patrickhirsh/Uniform-Keyboard/README.md

# Uniform65 Keyboard
A custom semi-ortholinear stabless mechanical keyboard
