patrickhirsh/Uniform-Keyboard/Ref/keyboard-layout-editor-schematic.txt

[{w:1.5},"Esc","1","2","3","4","5","6","7","8","9","0","-","=",{w:1.5},"Backspace"],
[{w:1.5},"Tab","Q","W","E","R","T","Y","U","I","O","P","[","]",{w:1.5},"|"],    
[{w:1.5},"Caps Lock","A","S","D","F","G","H","J","K","L",";","'",{w:1.5},"Enter","Home"],
[{w:1.5},"Shift","Z","X","C","V","B","N","M","<",">","?",{w:1.5},"Shift","Up","End"],
[{w:1.5},"Ctrl","Win","Alt",{x:0.5,w:1.5},"Space","Fn0",{w:1.5},"Space",{x:0.5},"Fn1","Fn2","Fn3",{x:0.5},"Left","Down","Right"]
