patrickhirsh/Uniform-Keyboard/Doc/Uniform_PCB_Wireframe.PNG

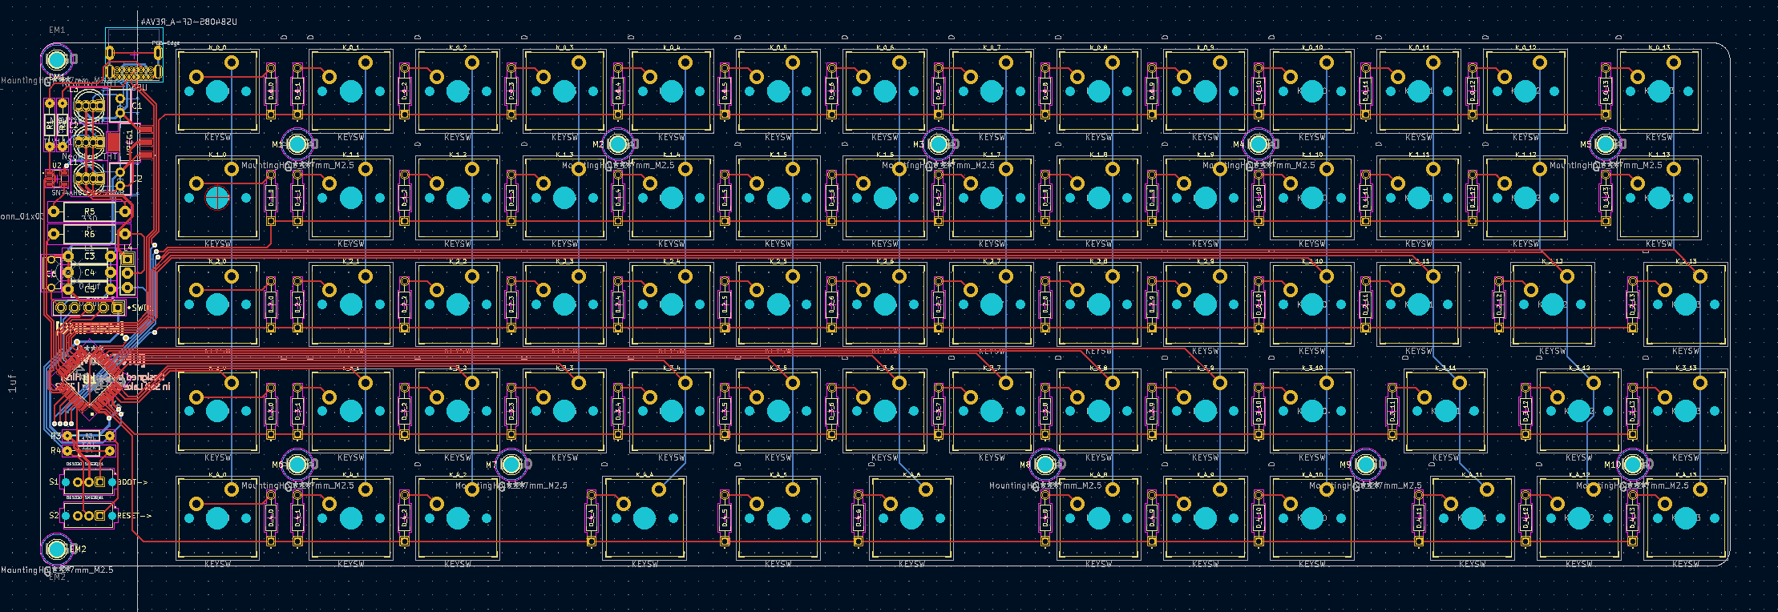
Doc/Uniform_PCB_Wireframe.PNG
