patrickhirsh/Uniform-Keyboard/Doc/Uniform_Tofu65_Example_2.jpeg

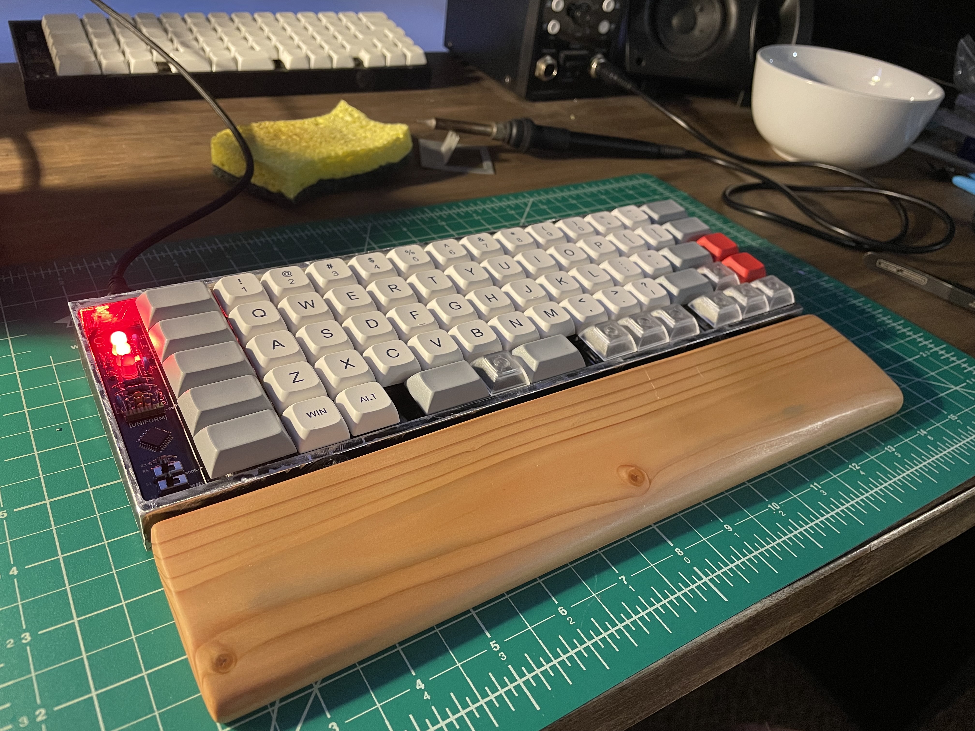
Doc/Uniform_Tofu65_Example_2.jpeg
