patrickhirsh/Uniform-Keyboard/Ref/keyboard-layout-matrix.PNG

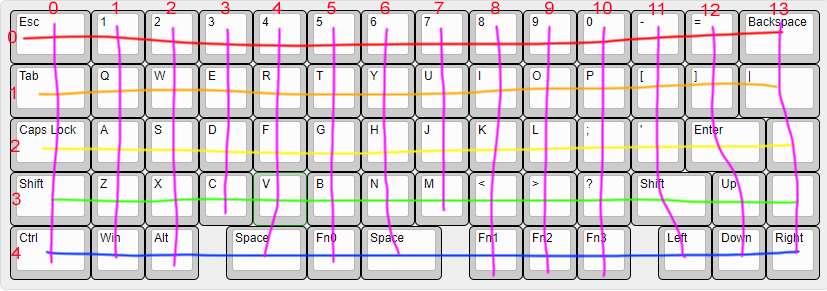
Ref/keyboard-layout-matrix.PNG
