patrickhirsh/Uniform-Keyboard/Ref/silkscreen graphics/graphic_designed-by-with-year.png

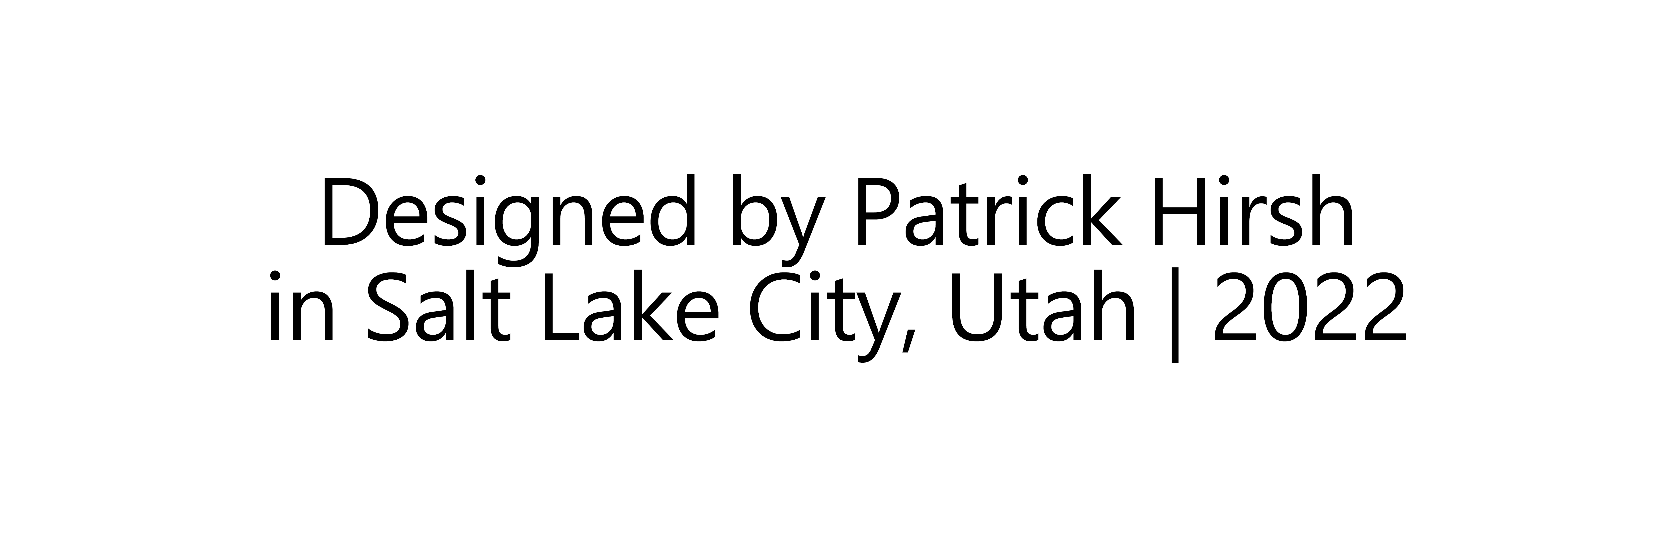
Ref/silkscreen graphics/graphic_designed-by-with-year.png
