patrickhirsh/Uniform-Keyboard/PCB/Uniform_Board/Uniform_Board.step

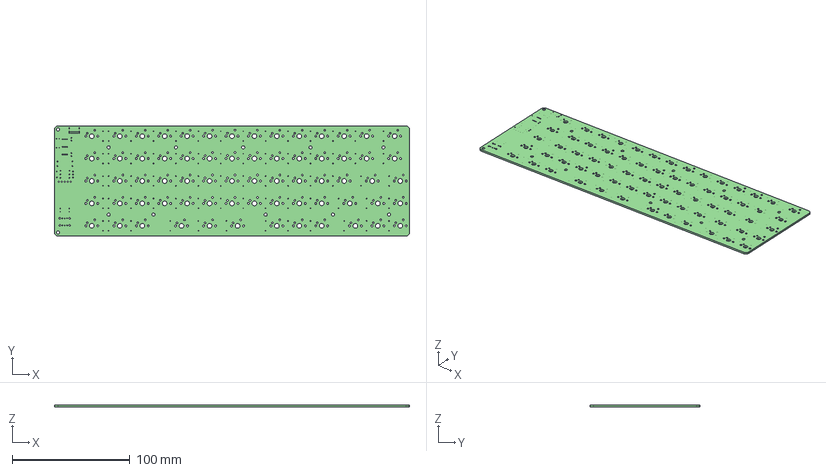
[picture p5: CAD file, 2022-08-30]
PCB/Uniform_Board/Uniform_Board.step
301.5 x 93.4 x 1.60 mm
