patrickhirsh/Uniform-Keyboard/Ref/uniform_layout.dxf

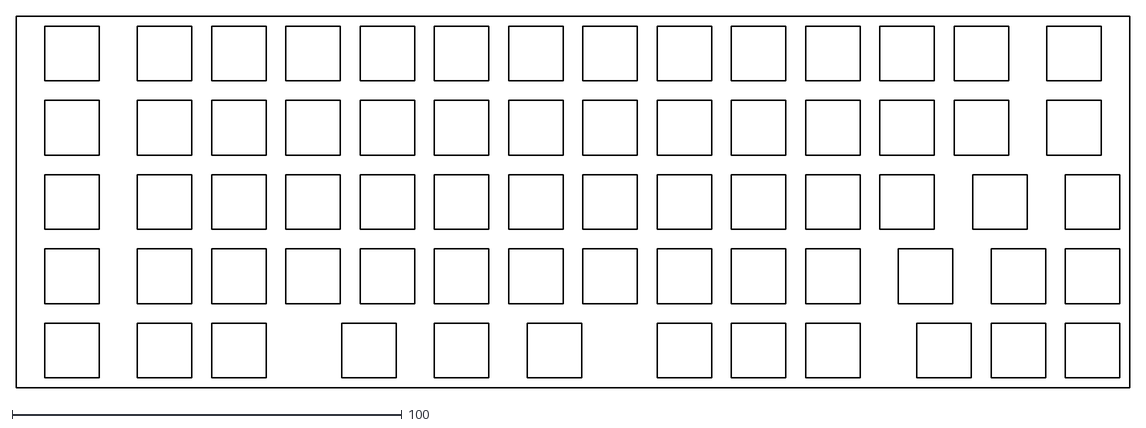
[picture p6: CAD file, 2022-02-06]
Ref/uniform_layout.dxf
285.7 x 95.2
