patrickhirsh/Uniform-Keyboard/PCB/lib-legacy/1-2199299-5/1-2199299-5.stp

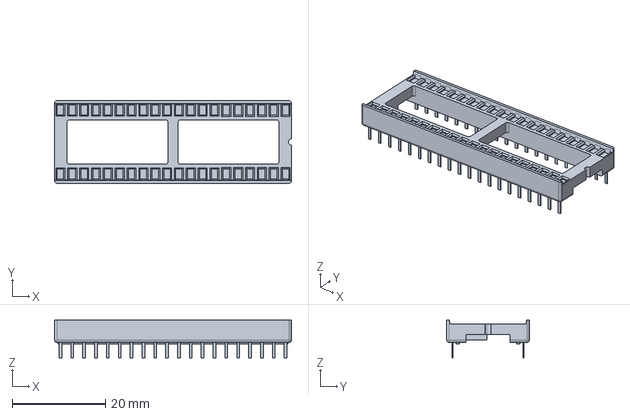
[picture p7: CAD file, 2022-05-01, an earlier design]
PCB/lib-legacy/1-2199299-5/1-2199299-5.stp
50.8 x 17.7 x 8.10 mm
