patrickhirsh/Uniform-Keyboard/PCB/lib-legacy/RCE5C2A220J0A2H03B-pcb-part-libraries/RCE5C2A220J0A2H03B.stp

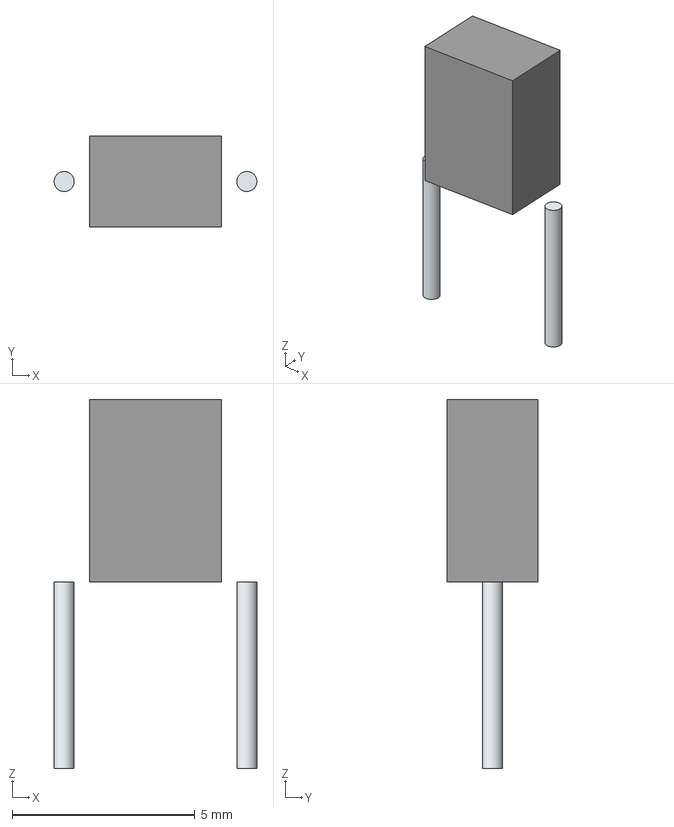
[picture p8: CAD file, 2022-05-01, an earlier design]
PCB/lib-legacy/RCE5C2A220J0A2H03B-pcb-part-libraries/RCE5C2A220J0A2H03B.stp
5.55 x 2.50 x 10.1 mm
Leads x 2
