patrickhirsh/Uniform-Keyboard/PCB/lib-legacy/RDER71H105K2M1H03A/RDER71H105K2M1H03A.step

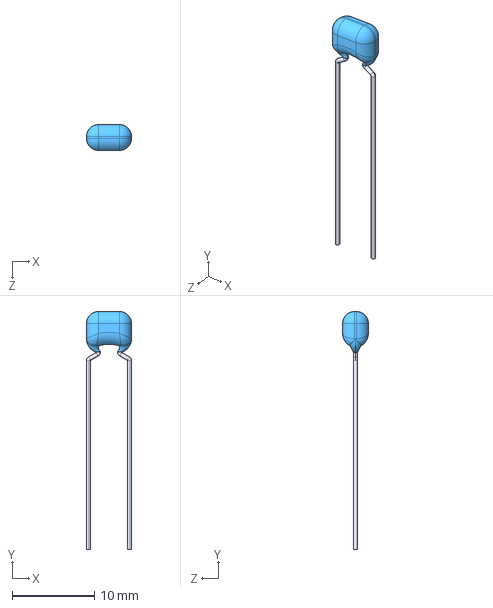
[picture p9: CAD file, 2022-02-09, an earlier design]
PCB/lib-legacy/RDER71H105K2M1H03A/RDER71H105K2M1H03A.step
5.50 x 29.0 x 3.15 mm
