patrickhirsh/Uniform-Keyboard/PCB/lib-legacy/SN74AHCT1G125DBVR/SN74AHCT1G125DBVR.step

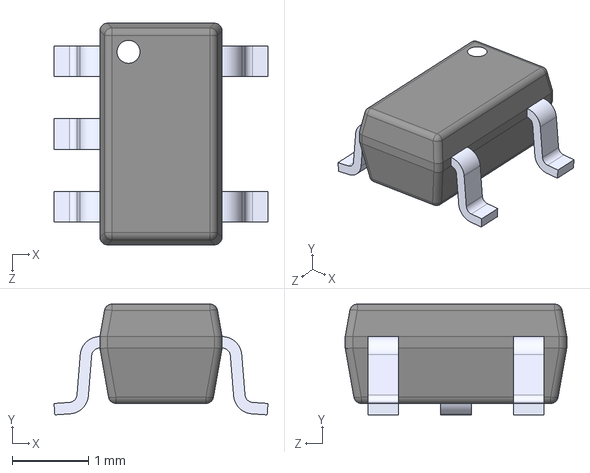
[picture p10: CAD file, 2022-05-30, an earlier design]
PCB/lib-legacy/SN74AHCT1G125DBVR/SN74AHCT1G125DBVR.step
2.80 x 1.45 x 2.90 mm
