patrickhirsh/Uniform-Keyboard/PCB/lib-legacy/STM32L072KZT6/STM32L072KZT6.stp

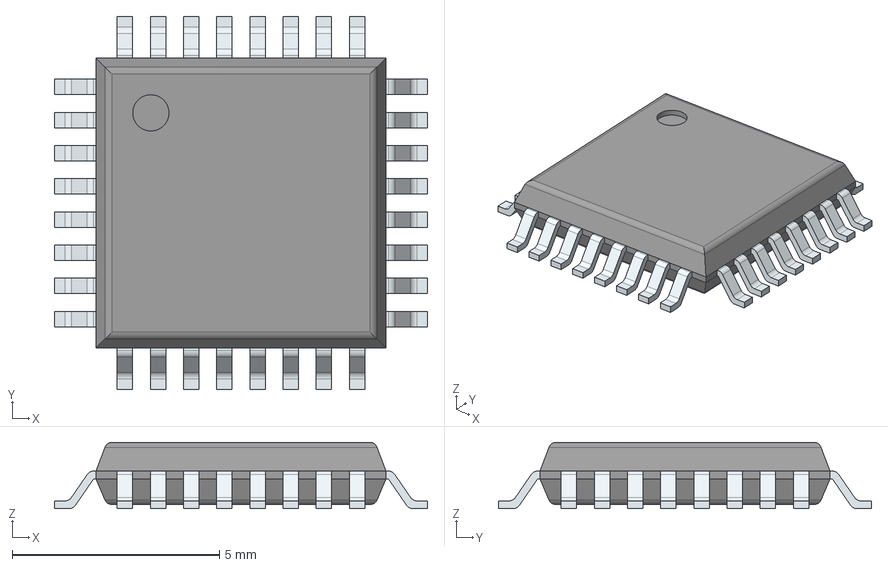
[picture p11: CAD file, 2022-02-08, an earlier design]
PCB/lib-legacy/STM32L072KZT6/STM32L072KZT6.stp
9.00 x 9.00 x 1.60 mm
PinsArrayLR
PinsArrayTB
