patrickhirsh/Uniform-Keyboard/PCB/lib-legacy/TLV1117-33IDCY/TLV1117-33IDCY.step

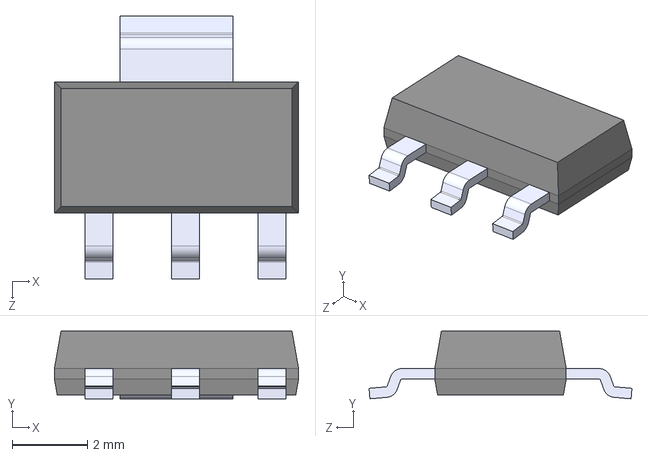
[picture p12: CAD file, 2022-02-06, an earlier design]
PCB/lib-legacy/TLV1117-33IDCY/TLV1117-33IDCY.step
6.50 x 1.80 x 7.00 mm
