patrickhirsh/Uniform-Keyboard/PCB/lib-legacy/826629-5/826629-5.step

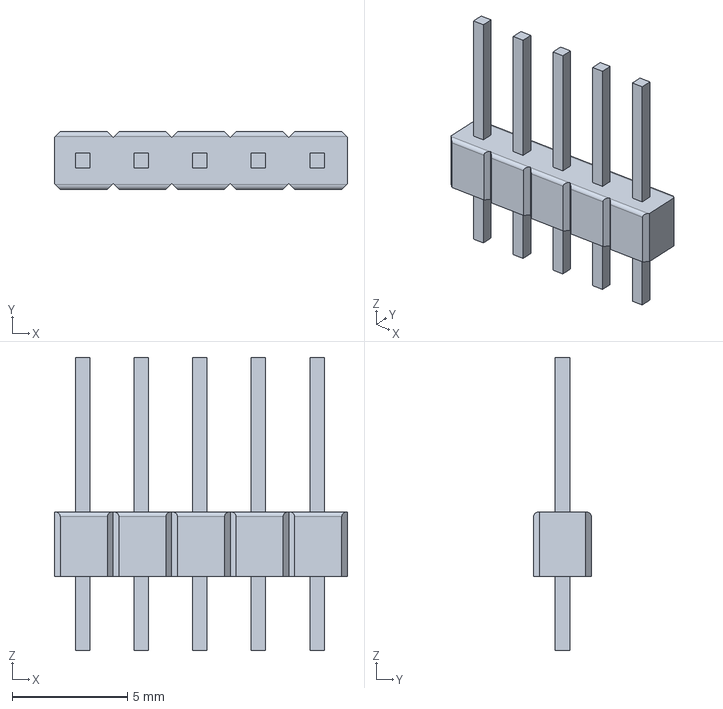
[picture p13: CAD file, 2022-02-08, an earlier design]
PCB/lib-legacy/826629-5/826629-5.step
12.7 x 2.50 x 12.7 mm
