patrickhirsh/Uniform-Keyboard/PCB/lib-legacy/OS102011MS2QN1/OS102011MS2QN1.step

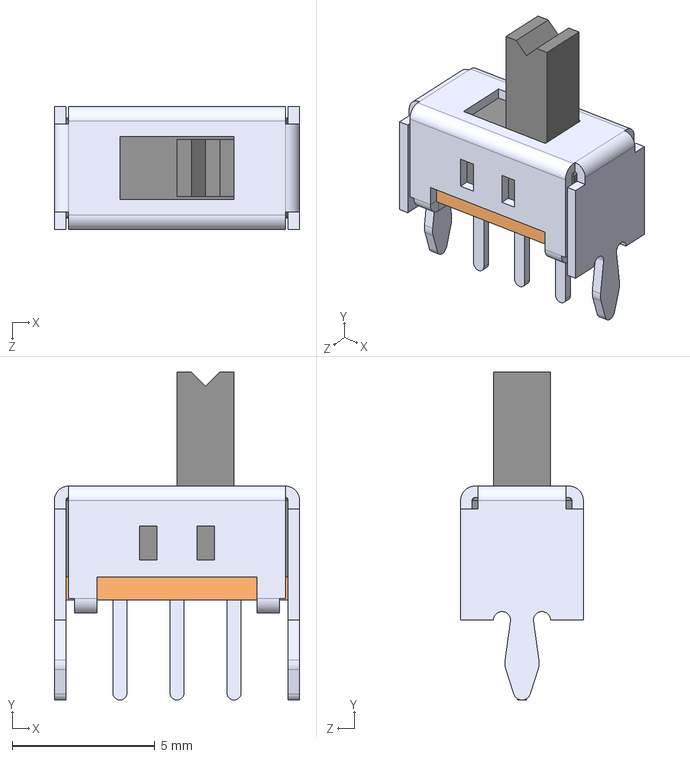
[picture p14: CAD file, 2022-02-07, an earlier design]
PCB/lib-legacy/OS102011MS2QN1/OS102011MS2QN1.step
8.60 x 11.5 x 4.30 mm
