patrickhirsh/Uniform-Keyboard/(list of files, cad)

Other CAD files:
PCB/lib-legacy/RCE5C2A220J0A2H03B-pcb-part-libraries/RCE5C2A220J0A2H03B.stl
PCB/lib-legacy/STM32L072KZT6/STM32L072KZT6.stl
