patrickhirsh/Uniform-Keyboard/PCB/Uniform_Module/Uniform_Module.kicad_pcb

## KiCad design PCB/Uniform_Module/Uniform_Module.kicad_pcb (2024-03-03)

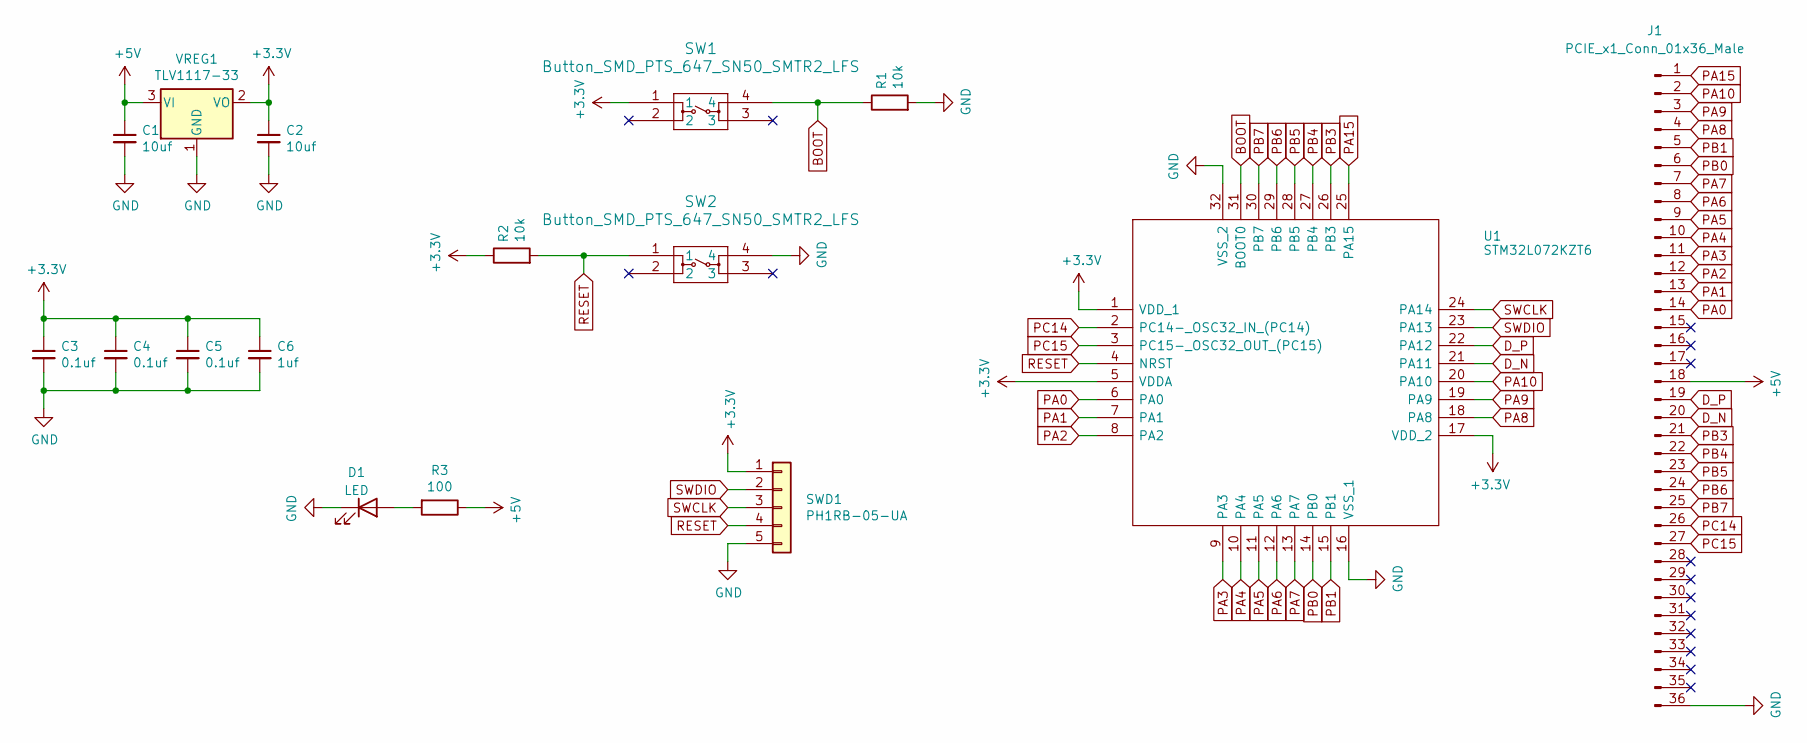
[picture p35: schematic Uniform_Module.kicad_sch, Uniform Keyboard]

Parts:
C1, C2: 10uf; C_0603_1608Metric_Pad1.08x0.95mm_HandSolder
C3, C4, C5: 0.1uf; C_0603_1608Metric_Pad1.08x0.95mm_HandSolder
C6: 1uf; C_0603_1608Metric_Pad1.08x0.95mm_HandSolder
D1: LED; LED_0603_1608Metric_Pad1.05x0.95mm_HandSolder
J1: PCIE_x1_Conn_01x36_Male; SAMTEC_PCIE_x1_CARD_EDGE_02_X_D_TH
R1, R2: 10k; R_0603_1608Metric_Pad0.98x0.95mm_HandSolder
R3: 100; R_0603_1608Metric_Pad0.98x0.95mm_HandSolder
SW1, SW2: Button_SMD_PTS_647_SN50_SMTR2_LFS; Button SMD PTS 647 SN50 SMTR2 LFS
SWD1: PH1RB-05-UA; PinHeader_1x05_P2.54mm_Vertical
U1: STM32L072KZT6; QFP80P900X900X160-32N; Mouser Part Number 511-STM32L072KZT6
VREG1: TLV1117-33; SOT230P700X180-4N

Connections:
+3V3: C2.1, C3.1, C4.1, C5.1, C6.1, R2.1, SW1.1, SWD1.1, U1.1 (VDD_1), U1.5 (VDDA), U1.17 (VDD_2), VREG1.2 (VO)
+5V: C1.1, J1.18, R3.1, VREG1.3 (VI)
BOOT: R1.1, SW1.4, U1.31 (BOOT0)
D_N: J1.20, U1.21 (PA11)
D_P: J1.19, U1.22 (PA12)
GND: C1.2, C2.2, C3.2, C4.2, C5.2, C6.2, D1.1 (K), J1.36, R1.2, SW2.4, SWD1.5, U1.16 (VSS_1), U1.32 (VSS_2), VREG1.1 (GND)
unnamed: D1.2 (A), R3.2
PA0: J1.14, U1.6 (PA0)
PA1: J1.13, U1.7 (PA1)
PA2: J1.12, U1.8 (PA2)
PA3: J1.11, U1.9 (PA3)
PA4: J1.10, U1.10 (PA4)
PA5: J1.9, U1.11 (PA5)
PA6: J1.8, U1.12 (PA6)
PA7: J1.7, U1.13 (PA7)
PA8: J1.4, U1.18 (PA8)
PA9: J1.3, U1.19 (PA9)
PA10: J1.2, U1.20 (PA10)
PA15: J1.1, U1.25 (PA15)
PB0: J1.6, U1.14 (PB0)
PB1: J1.5, U1.15 (PB1)
PB3: J1.21, U1.26 (PB3)
PB4: J1.22, U1.27 (PB4)
PB5: J1.23, U1.28 (PB5)
PB6: J1.24, U1.29 (PB6)
PB7: J1.25, U1.30 (PB7)
PC14: J1.26, U1.2 (PC14-_OSC32_IN_(PC14))
PC15: J1.27, U1.3 (PC15-_OSC32_OUT_(PC15))
RESET: R2.2, SW2.1, SWD1.4, U1.4 (NRST)
SWCLK: SWD1.3, U1.24 (PA14)
SWDIO: SWD1.2, U1.23 (PA13)

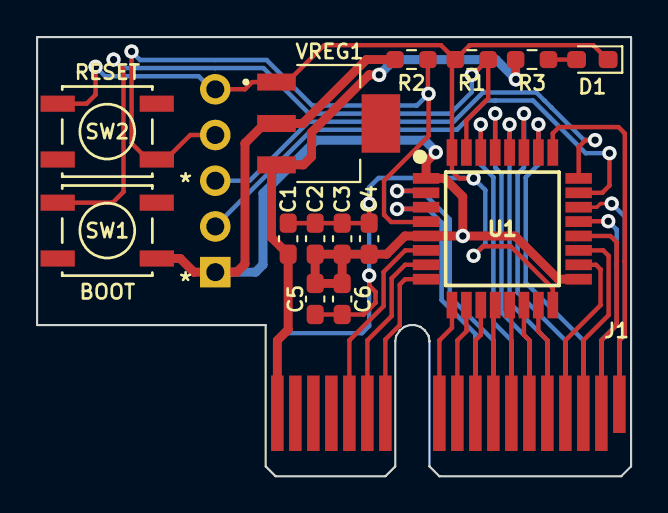
[picture p36: board Uniform_Module.kicad_pcb from above]

Board: 2 copper layers, 33.0 x 24.4 mm, 16 parts (1 on the bottom side), 31 nets.
