patrickhirsh/Uniform-Keyboard/PCB/Uniform_Board/Uniform_Board.kicad_pcb

## KiCad design PCB/Uniform_Board/Uniform_Board.kicad_pcb (2024-03-03)

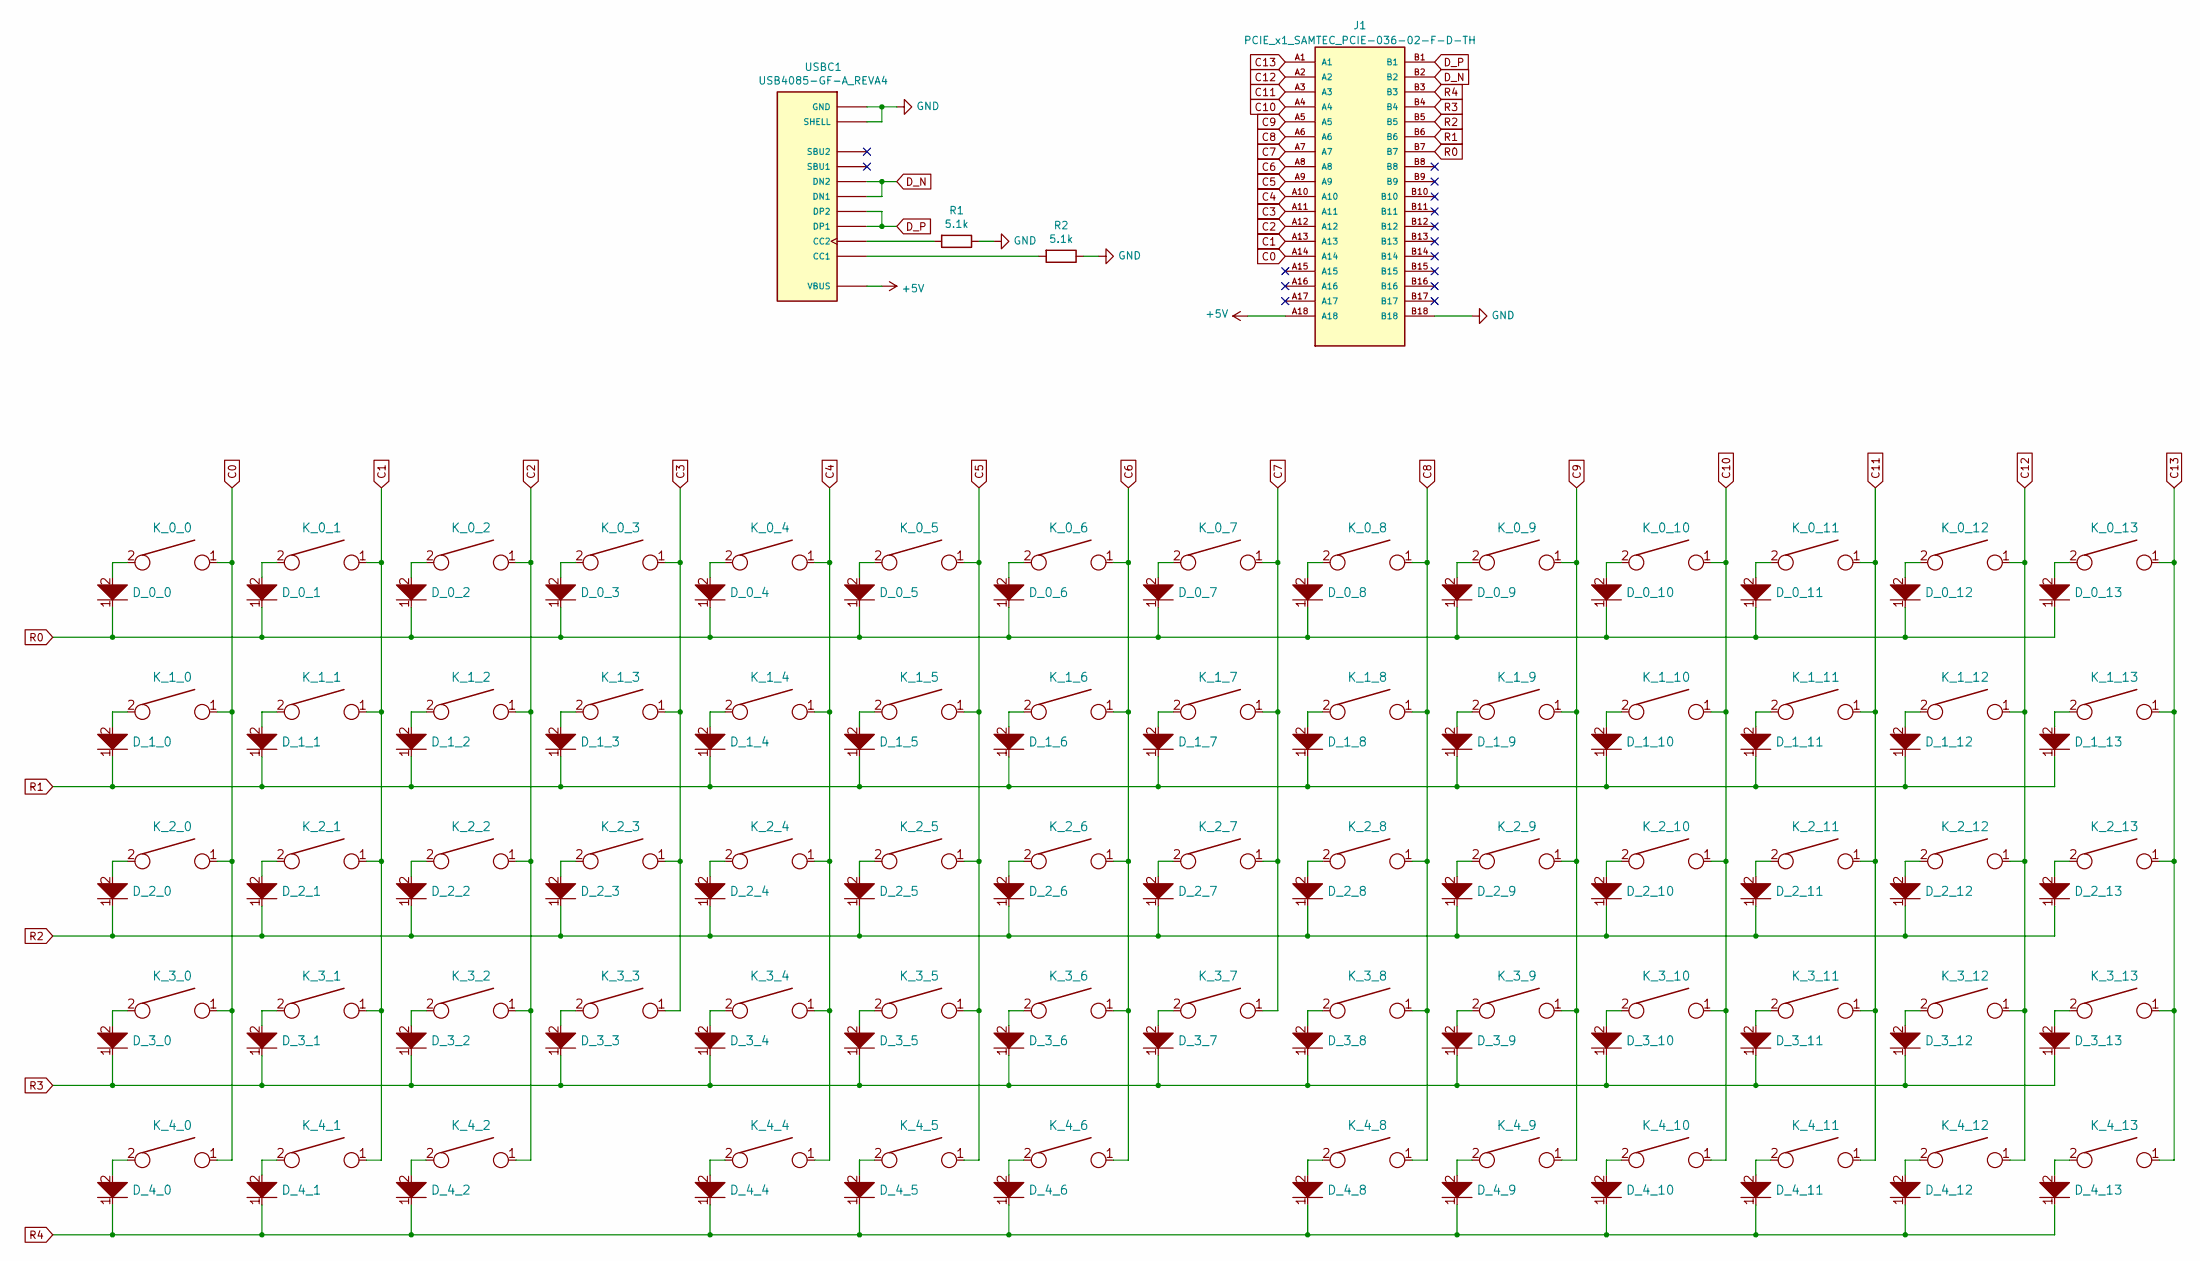
[picture p37: schematic Uniform_Board.kicad_sch, Uniform Keyboard]

Parts:
D_0_0, D_0_1, D_0_2, D_0_3, D_0_4, D_0_5, D_0_6, D_0_7, D_0_8, D_0_9, D_0_10, D_0_11, D_0_12, D_0_13, D_1_0, D_1_1, D_1_2, D_1_3, D_1_4, D_1_5, D_1_6, D_1_7, D_1_8, D_1_9, D_1_10, D_1_11, D_1_12, D_1_13, D_2_0, D_2_1, D_2_2, D_2_3, D_2_4, D_2_5, D_2_6, D_2_7, D_2_8, D_2_9, D_2_10, D_2_11, D_2_12, D_2_13, D_3_0, D_3_1, D_3_2, D_3_3, D_3_4, D_3_5, D_3_6, D_3_7, D_3_8, D_3_9, D_3_10, D_3_11, D_3_12, D_3_13, D_4_0, D_4_1, D_4_2, D_4_4, D_4_5, D_4_6, D_4_8, D_4_9, D_4_10, D_4_11, D_4_12, D_4_13: D; Diode_DIOAD829W49L456D191
J1: PCIE_x1_SAMTEC_PCIE-036-02-F-D-TH; SAMTEC_PCIE-036-02-F-D-TH
K_0_0, K_0_1, K_0_2, K_0_3, K_0_4, K_0_5, K_0_6, K_0_7, K_0_8, K_0_9, K_0_10, K_0_11, K_0_12, K_0_13, K_1_0, K_1_1, K_1_2, K_1_3, K_1_4, K_1_5, K_1_6, K_1_7, K_1_8, K_1_9, K_1_10, K_1_11, K_1_12, K_1_13, K_2_0, K_2_1, K_2_2, K_2_3, K_2_4, K_2_5, K_2_6, K_2_7, K_2_8, K_2_9, K_2_10, K_2_11, K_2_12, K_2_13, K_3_0, K_3_1, K_3_2, K_3_3, K_3_4, K_3_5, K_3_6, K_3_7, K_3_8, K_3_9, K_3_10, K_3_11, K_3_12, K_3_13, K_4_0, K_4_1, K_4_2, K_4_4, K_4_5, K_4_6, K_4_8, K_4_9, K_4_10, K_4_11, K_4_12, K_4_13: KEYSW; SW_MX
R1, R2: 5.1k; R_0603_1608Metric_Pad0.98x0.95mm_HandSolder
USBC1: USB4085-GF-A_REVA4; USBC_USB4085-GF-A; PARTREV A4

Connections:
+5V: J1.A18, USBC1.A4 (VBUS), USBC1.A9 (VBUS), USBC1.B4 (VBUS), USBC1.B9 (VBUS)
C0: J1.A14, K_0_0.1, K_1_0.1, K_2_0.1, K_3_0.1, K_4_0.1
C1: J1.A13, K_0_1.1, K_1_1.1, K_2_1.1, K_3_1.1, K_4_1.1
C2: J1.A12, K_0_2.1, K_1_2.1, K_2_2.1, K_3_2.1, K_4_2.1
C3: J1.A11, K_0_3.1, K_1_3.1, K_2_3.1, K_3_3.1
C4: J1.A10, K_0_4.1, K_1_4.1, K_2_4.1, K_3_4.1, K_4_4.1
C5: J1.A9, K_0_5.1, K_1_5.1, K_2_5.1, K_3_5.1, K_4_5.1
C6: J1.A8, K_0_6.1, K_1_6.1, K_2_6.1, K_3_6.1, K_4_6.1
C7: J1.A7, K_0_7.1, K_1_7.1, K_2_7.1, K_3_7.1
C8: J1.A6, K_0_8.1, K_1_8.1, K_2_8.1, K_3_8.1, K_4_8.1
C9: J1.A5, K_0_9.1, K_1_9.1, K_2_9.1, K_3_9.1, K_4_9.1
C10: J1.A4, K_0_10.1, K_1_10.1, K_2_10.1, K_3_10.1, K_4_10.1
C11: J1.A3, K_0_11.1, K_1_11.1, K_2_11.1, K_3_11.1, K_4_11.1
C12: J1.A2, K_0_12.1, K_1_12.1, K_2_12.1, K_3_12.1, K_4_12.1
C13: J1.A1, K_0_13.1, K_1_13.1, K_2_13.1, K_3_13.1, K_4_13.1
D_N: J1.B2, USBC1.A7 (DN1), USBC1.B7 (DN2)
D_P: J1.B1, USBC1.A6 (DP1), USBC1.B6 (DP2)
GND: J1.B18, R1.1, R2.1, USBC1.A1 (GND), USBC1.A12 (GND), USBC1.B1 (GND), USBC1.B12 (GND), USBC1.P1 (SHELL), USBC1.P2 (SHELL), USBC1.P3 (SHELL), USBC1.P4 (SHELL)
unnamed: D_0_0.2, K_0_0.2
unnamed: D_0_1.2, K_0_1.2
unnamed: D_0_2.2, K_0_2.2
unnamed: D_0_3.2, K_0_3.2
unnamed: D_0_4.2, K_0_4.2
unnamed: D_0_5.2, K_0_5.2
unnamed: D_0_6.2, K_0_6.2
unnamed: D_0_7.2, K_0_7.2
unnamed: D_0_8.2, K_0_8.2
unnamed: D_0_9.2, K_0_9.2
unnamed: D_0_10.2, K_0_10.2
unnamed: D_0_11.2, K_0_11.2
unnamed: D_0_12.2, K_0_12.2
unnamed: D_0_13.2, K_0_13.2
unnamed: D_1_0.2, K_1_0.2
unnamed: D_1_1.2, K_1_1.2
unnamed: D_1_2.2, K_1_2.2
unnamed: D_1_3.2, K_1_3.2
unnamed: D_1_4.2, K_1_4.2
unnamed: D_1_5.2, K_1_5.2
unnamed: D_1_6.2, K_1_6.2
unnamed: D_1_7.2, K_1_7.2
unnamed: D_1_8.2, K_1_8.2
unnamed: D_1_9.2, K_1_9.2
unnamed: D_1_10.2, K_1_10.2
unnamed: D_1_11.2, K_1_11.2
unnamed: D_1_12.2, K_1_12.2
unnamed: D_1_13.2, K_1_13.2
unnamed: D_2_0.2, K_2_0.2
unnamed: D_2_1.2, K_2_1.2
unnamed: D_2_2.2, K_2_2.2
unnamed: D_2_3.2, K_2_3.2
unnamed: D_2_4.2, K_2_4.2
unnamed: D_2_5.2, K_2_5.2
unnamed: D_2_6.2, K_2_6.2
unnamed: D_2_7.2, K_2_7.2
unnamed: D_2_8.2, K_2_8.2
unnamed: D_2_9.2, K_2_9.2
unnamed: D_2_10.2, K_2_10.2
unnamed: D_2_11.2, K_2_11.2
unnamed: D_2_12.2, K_2_12.2
unnamed: D_2_13.2, K_2_13.2
unnamed: D_3_0.2, K_3_0.2
unnamed: D_3_1.2, K_3_1.2
unnamed: D_3_2.2, K_3_2.2
unnamed: D_3_3.2, K_3_3.2
unnamed: D_3_4.2, K_3_4.2
unnamed: D_3_5.2, K_3_5.2
unnamed: D_3_6.2, K_3_6.2
unnamed: D_3_7.2, K_3_7.2
unnamed: D_3_8.2, K_3_8.2
unnamed: D_3_9.2, K_3_9.2
unnamed: D_3_10.2, K_3_10.2
unnamed: D_3_11.2, K_3_11.2
unnamed: D_3_12.2, K_3_12.2
unnamed: D_3_13.2, K_3_13.2
unnamed: D_4_0.2, K_4_0.2
unnamed: D_4_1.2, K_4_1.2
unnamed: D_4_2.2, K_4_2.2
unnamed: D_4_4.2, K_4_4.2
unnamed: D_4_5.2, K_4_5.2
unnamed: D_4_6.2, K_4_6.2
unnamed: D_4_8.2, K_4_8.2
unnamed: D_4_9.2, K_4_9.2
unnamed: D_4_10.2, K_4_10.2
unnamed: D_4_11.2, K_4_11.2
unnamed: D_4_12.2, K_4_12.2
unnamed: D_4_13.2, K_4_13.2
unnamed: R1.2, USBC1.B5 (CC2)
unnamed: R2.2, USBC1.A5 (CC1)
R0: D_0_0.1, D_0_1.1, D_0_2.1, D_0_3.1, D_0_4.1, D_0_5.1, D_0_6.1, D_0_7.1, D_0_8.1, D_0_9.1, D_0_10.1, D_0_11.1, D_0_12.1, D_0_13.1, J1.B7
R1: D_1_0.1, D_1_1.1, D_1_2.1, D_1_3.1, D_1_4.1, D_1_5.1, D_1_6.1, D_1_7.1, D_1_8.1, D_1_9.1, D_1_10.1, D_1_11.1, D_1_12.1, D_1_13.1, J1.B6
R2: D_2_0.1, D_2_1.1, D_2_2.1, D_2_3.1, D_2_4.1, D_2_5.1, D_2_6.1, D_2_7.1, D_2_8.1, D_2_9.1, D_2_10.1, D_2_11.1, D_2_12.1, D_2_13.1, J1.B5
R3: D_3_0.1, D_3_1.1, D_3_2.1, D_3_3.1, D_3_4.1, D_3_5.1, D_3_6.1, D_3_7.1, D_3_8.1, D_3_9.1, D_3_10.1, D_3_11.1, D_3_12.1, D_3_13.1, J1.B4
R4: D_4_0.1, D_4_1.1, D_4_2.1, D_4_4.1, D_4_5.1, D_4_6.1, D_4_8.1, D_4_9.1, D_4_10.1, D_4_11.1, D_4_12.1, D_4_13.1, J1.B3

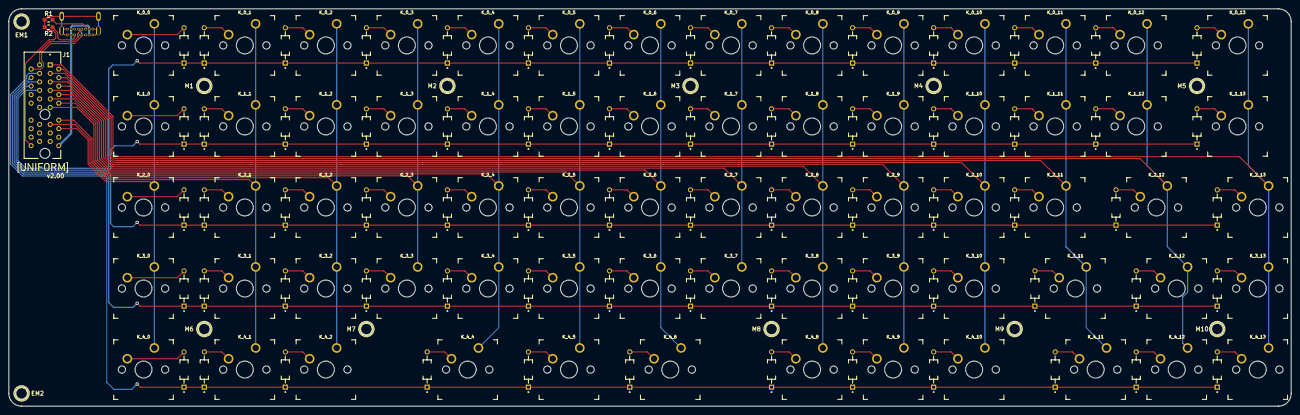
[picture p38: board Uniform_Board.kicad_pcb from above]

Board: 2 copper layers, 301.5 x 93.4 mm, 152 parts (1 on the bottom side), 93 nets.

Other parts of the board:
EM1, EM2: MountingHole_2.7mm_M2.5
M1, M2, M3, M4, M5, M6, M7, M8, M9, M10: MountingHole_2.7mm_M2.5
