patrickhirsh/Uniform-Keyboard/(commit log)

2022-02-04 added layout schematic
2022-02-05 Added gaps in bottom row schematic
2022-02-06 added KiCad libraries and new reference material
    [Uniform.kicad_pcb, Uniform.sch, uniform_layout.dxf]
2022-02-06 keyboard matrix schema finished
    [Uniform.sch]
2022-02-06 added diode labels
    [Uniform.sch]
2022-02-06 added crystal, voltage regulator, and boot/reset switches
    [Uniform.sch]
2022-02-07 added usb module to schema
    [Uniform.sch]
2022-02-07 mostly finished schema - need to select crystal and change flanking capacitor values accordingly
    [Uniform.sch]
2022-02-08 Switched MCUs to STM32L072KZT6 because the F3 series went out of stock..
    [Uniform.sch]
2022-02-09 Schematic complete
    [Uniform.sch]
2022-02-09 switch footprints layed out on PCB
    [Uniform.kicad_pcb, Uniform.sch]
2022-02-10 finished board outline
    [Uniform.kicad_pcb]
2022-02-10 flipped exposed PCB side to make room for USBC pins
    [Uniform.kicad_pcb]
2022-02-10 full layout first pass
    [Uniform.kicad_pcb]
2022-02-10 Tweaking some things
    [Uniform.kicad_pcb]
2022-02-10 moved status LED to a better location
    [Uniform.kicad_pcb]
2022-02-16 updating project to KiCad 6.0
    [Uniform.kicad_pcb, Uniform.kicad_sch, Uniform.sch]
2022-02-16 Added traces for all key switches
    [Uniform.kicad_pcb]
2022-02-17 about to attempt rotating the MCU
    [Uniform.kicad_pcb, Uniform.kicad_sch]
2022-02-17 re-worked layout to reduce ratsnest crossover
    [Uniform.kicad_pcb]
2022-02-17 PCB first pass complete
    [Uniform.kicad_pcb, Uniform.kicad_sch]
2022-02-17 Added SWD silkscreen
    [Uniform.kicad_pcb]
2022-02-18 silkscreen artwork added
    [Uniform.kicad_pcb]
2022-02-18 fixed stray silkscreen text
    [Uniform.kicad_pcb]
2022-02-19 v1 final gerber files submitted
    [Uniform-B_Cu.gbl, Uniform-B_Mask.gbs, Uniform-B_Paste.gbp, Uniform-B_Silkscreen.gbo, Uniform-Edge_Cuts.gm1, Uniform-F_Cu.gtl, Uniform-F_Mask.gts, Uniform-F_Paste.gtp]
2022-02-19 changed M3 mounting to M2.5 due to clearance issues
    [Uniform.kicad_pcb, uniform_plate.dxf]
2022-02-19 added mounting hole graphics
    [Uniform-B_Cu.gbl, Uniform-B_Mask.gbs, Uniform-B_Paste.gbp, Uniform-B_Silkscreen.gbo, Uniform-Edge_Cuts.gm1, Uniform-F_Cu.gtl, Uniform-F_Mask.gts, Uniform-F_Paste.gtp]
2022-05-01 Moved mount holes so the drill points in the plate won't collide with switch clip-in points
    [Uniform.kicad_pcb, Uniform.kicad_sch, Uniform.step]
2022-05-05 revert ATMEGA32 changes to schematic that were lumped into last commit
    [Uniform.kicad_sch]
2022-05-11 Added Neopixel status LED, moved mount holes, and re-routed traces to fit new status led type
    [Uniform.kicad_pcb, Uniform.kicad_sch]
2022-05-11 generated gerbers and finalized V2
    [Uniform-B_Cu.gbl, Uniform-B_Mask.gbs, Uniform-B_Paste.gbp, Uniform-B_Silkscreen.gbo, Uniform-Edge_Cuts.gm1, Uniform-F_Cu.gtl, Uniform-F_Mask.gts, Uniform-F_Paste.gtp]
2022-05-11 reduced neopixel pin drill hole size from .9 to .8 to accomodate typical minimum manufacturing hole spacing requirements
    [Uniform-B_Cu.gbl, Uniform-B_Mask.gbs, Uniform-B_Paste.gbp, Uniform-B_Silkscreen.gbo, Uniform-Edge_Cuts.gm1, Uniform-F_Cu.gtl, Uniform-F_Mask.gts, Uniform-F_Paste.gtp]
2022-05-30 Added 2 more Neopixels and supporting logic level shifter
    [Uniform.kicad_pcb, Uniform.kicad_sch]
2022-07-07 Move status LED resistor between the logic level shifter and the LED to fix flicker issue
    [Uniform-B_Cu.gbl, Uniform-B_Mask.gbs, Uniform-B_Paste.gbp, Uniform-B_Silkscreen.gbo, Uniform-Edge_Cuts.gm1, Uniform-F_Cu.gtl, Uniform-F_Mask.gts, Uniform-F_Paste.gtp]
2022-08-30 added Plate section
2022-08-30 build guide progress
    [Uniform.step]
2022-08-31 Refined Prep and Assembly sections
2022-09-02 Add link to gerber files
2022-09-03 switches and keycaps section, case section improvements with mounting information
2022-09-03 tweaked wording in Plate section
2022-09-03 add new images for plate drill holes and tofu65 mounting
2022-09-03 Tofu65 Mounting
2022-09-03 Tofu65 Mounting Example 2
2022-09-03 Plate section formatting
2022-09-03 Add plate drill hole example
2022-09-03 Added mount screw access holes example to Plate section
2022-09-03 add plate svg to plate section
2022-09-03 fix image name for plate file
2022-09-03 move plate image position in plate section
2022-09-03 Fix list spacing in PCB Assembly section
2024-02-17 move old libraries to 'legacy' and create new library for non-legacy symbols
    [1-2199299-5.stp, 1N4148.step, 826629-5.step, OS102011MS2QN1.step, RCE5C2A220J0A2H03B.stl, RCE5C2A220J0A2H03B.stp, RDER71H105K2M1H03A.step, SN74AHCT1G125DBVR.step]
2024-02-18 broke Uniform into two projects - uniform_board and uniform_module. Finished uniform_module schematic
    [Uniform_Board.kicad_sch, Uniform_Module.kicad_sch]
2024-02-18 completed uniform_board schematic
    [Uniform_Board.kicad_sch]
2024-02-19 board USBC and power routed to PCIE, pre row/column routing
    [Uniform_Board.kicad_pcb, Uniform_Board.kicad_sch]
2024-02-19 started board routing; first attempt
    [Uniform_Board.kicad_pcb, Uniform_Board.kicad_sch]
2024-02-19 rework routing on board, cleaner!
    [Uniform_Board.kicad_pcb]
2024-02-19 finished uniform board routing
    [Uniform_Board.kicad_pcb]
2024-02-19 fixed some minor routing issues on uniform board, removed silkscreen diode ref text
    [Uniform_Board.kicad_pcb]
2024-02-19 finishing touches on silkscreen graphics for board
    [Uniform_Board.kicad_pcb]
2024-02-20 PCIE slot is upside down... began footprint, comitting changes and preparing to re-route on board :(
    [Uniform_Module.kicad_pcb, Uniform_Module.kicad_sch]
2024-02-26 PCIE Edge Connector footprint dimmensions and edge cuts done
    [Uniform_Board.kicad_pcb, Uniform_Board.kicad_sch]
2024-02-28 began routing for uniform module
    [Uniform_Module.kicad_pcb, Uniform_Module.kicad_sch]
2024-02-28 clear all routing on module. Fix incorrect PCIE edge connector schematic net assignments
    [Uniform_Module.kicad_pcb, Uniform_Module.kicad_sch]
2024-02-29 improved trace origins on PCIE port/edge. Board rerouting done. Module rerouting in progress
    [Uniform_Board.kicad_pcb, Uniform_Board.kicad_sch, Uniform_Module.kicad_pcb, Uniform_Module.kicad_sch]
2024-02-29 first pass at module layout. silkscreen added
    [Uniform_Module.kicad_pcb]
2024-02-29 uniform module routing half done
    [Uniform_Module.kicad_pcb]
2024-03-03 Uniform module traces first pass complete
    [Uniform_Board.kicad_pcb, Uniform_Module.kicad_pcb]
2024-03-03 Uniform Module passing DRC
    [Uniform_Module.kicad_pcb]
2024-03-03 silkscreen work and minor tweaks to uniform module board
    [Uniform_Module.kicad_pcb]
