patrickhirsh/Uniform-Keyboard/Doc/Uniform_10u_Back.jpeg

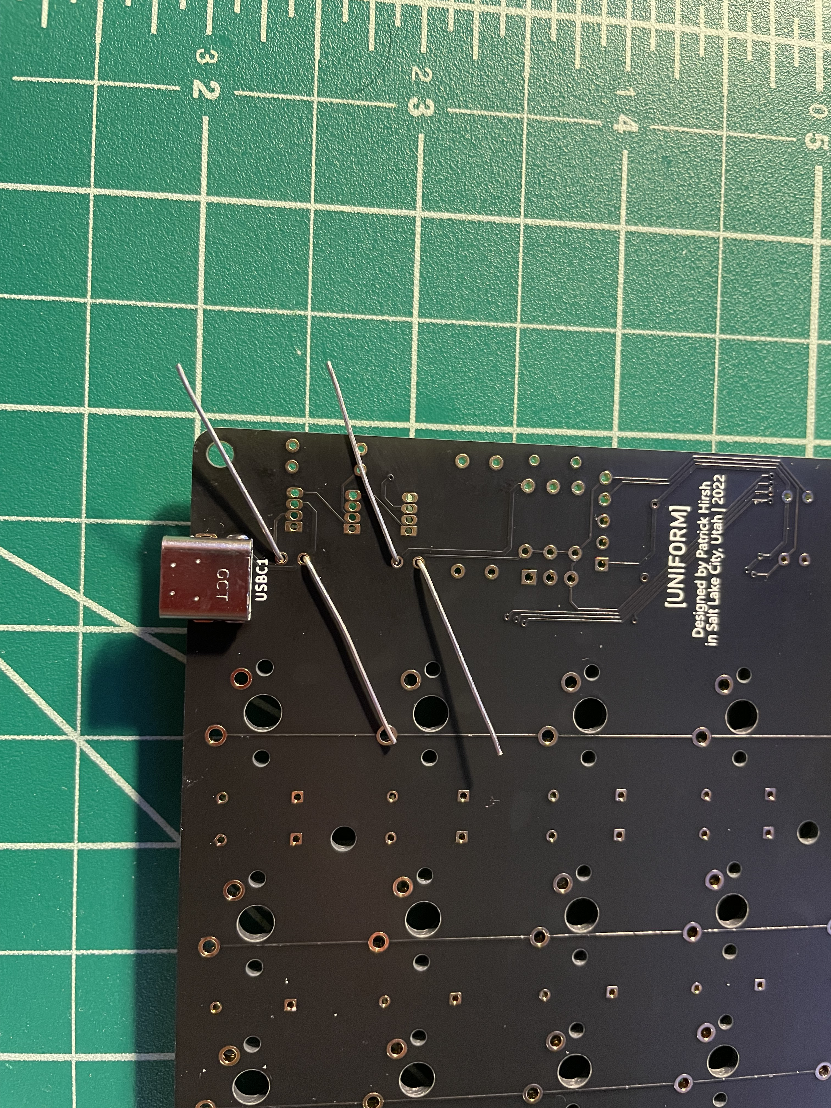
[picture p23: Doc/Uniform_10u_Back.jpeg]
Doc/Uniform_10u_Back.jpeg
